LukeVassallo/tt03-xor-cipher/dual_xor_signature_arty35t_vivado/docs/dual_xor_fpga_signature.pdf

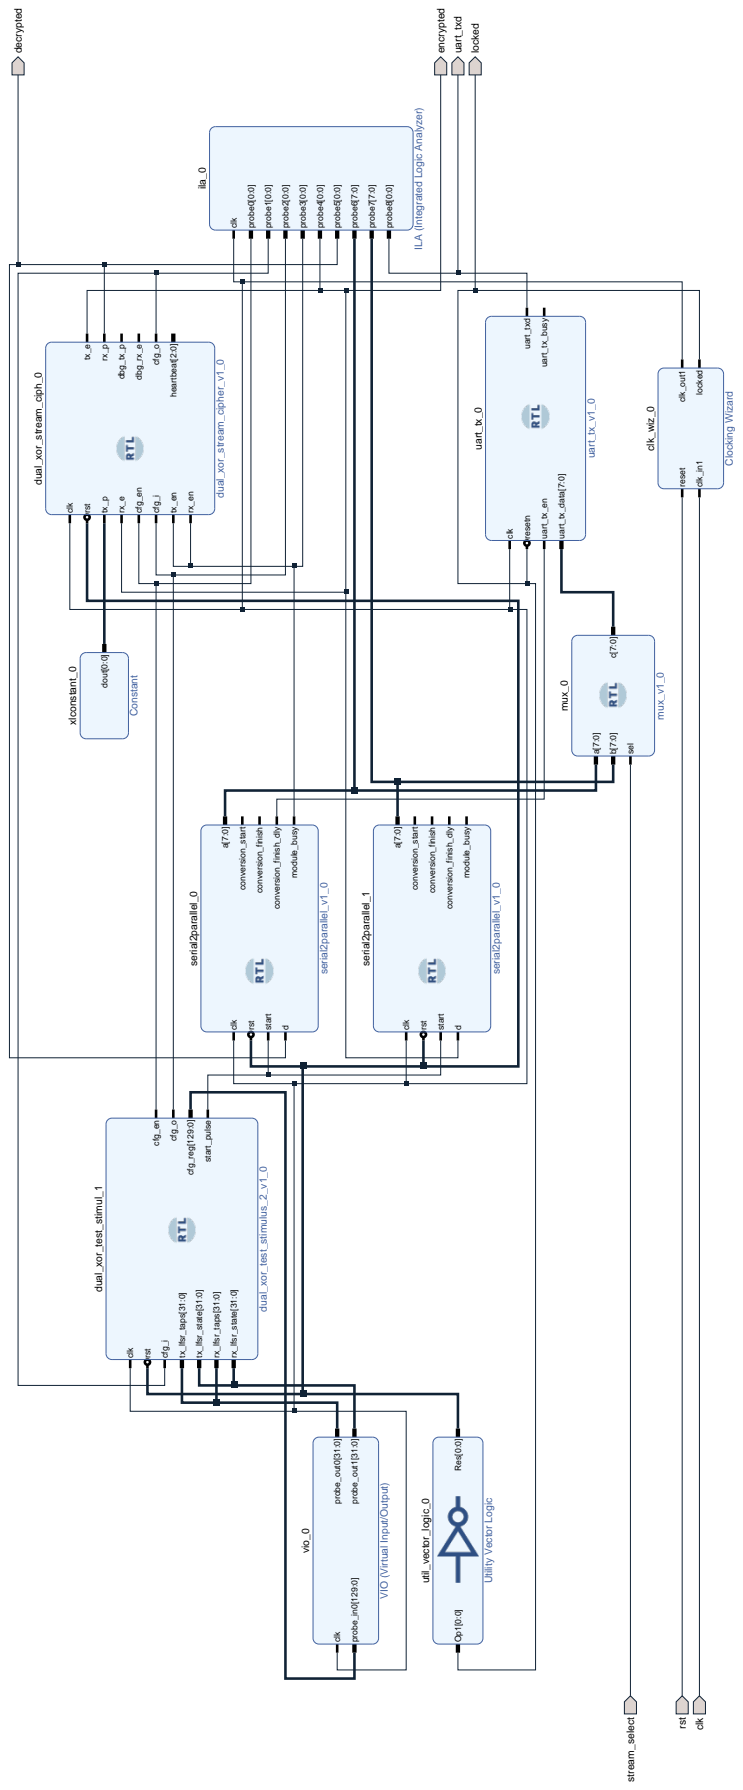
[picture p10: page 1]
stream_select; rst; clk; vio_0; probe_in0[129:0]; probe_out0[31:0]; probe_out1[31:0]; util_vector_logic_0; Op1[0:0] Res[0:0]; dual_xor_test_stimul_1; dual_xor_test_stimulus_2_v1_0; rst cfg_en; cfg_o; cfg_i; cfg_reg[129:0]; tx_lfsr_taps[31:0]; tx_lfsr_state[31:0]; rx_lfsr_taps[31:0]; rx_lfsr_state[31:0]; start_pulse; serial2parallel_0; serial2parallel_v1_0; start; conversion_start; conversion_finish; conversion_finish_dly; module_busy; serial2parallel_1; xlconstant_0; Constant; dout[0:0]; mux_0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

ILA (Integrated Logic Analyzer)

VIO (Virtual Input/Output)

Utility Vector Logic
