LukeVassallo/tt03-xor-cipher/dual_xor_basic_arty35t_vivado/docs/dual_xor_fpga_basic.pdf

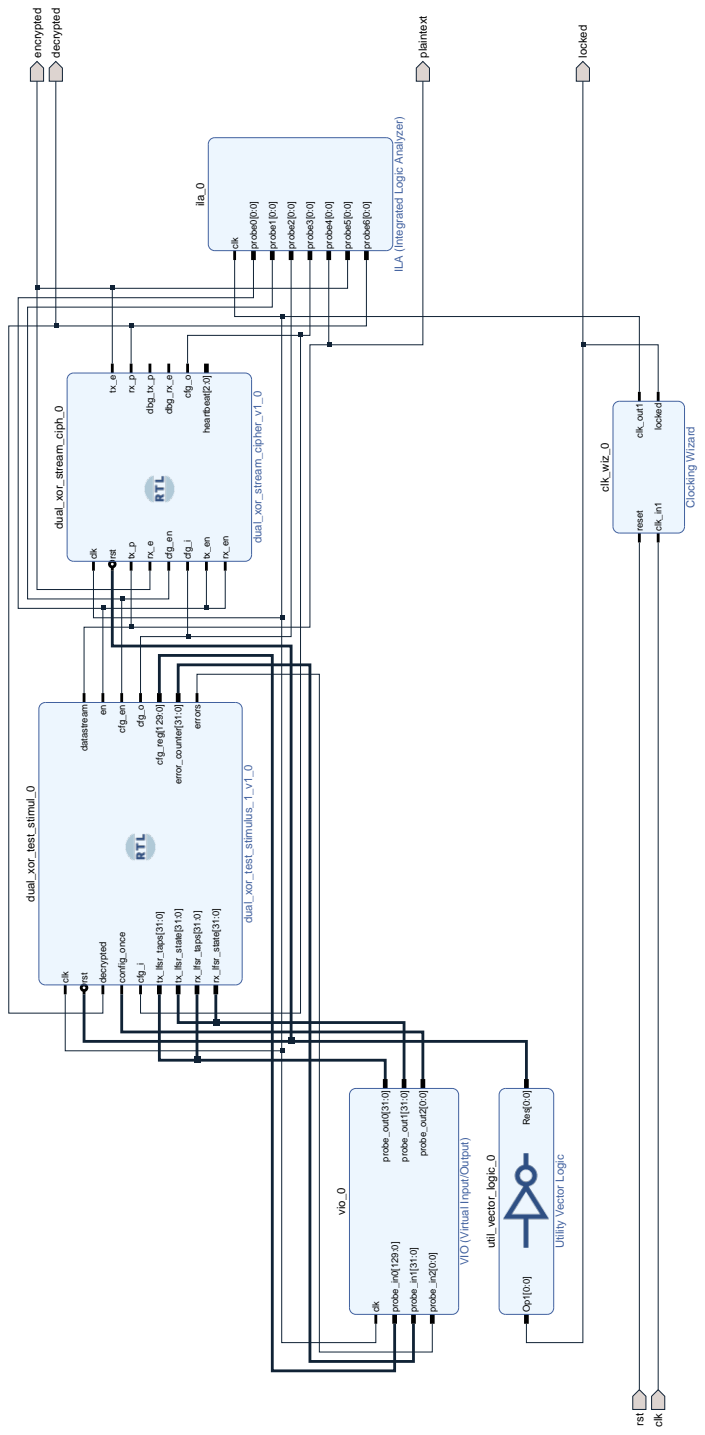
[picture p11: page 1]
rst; clk; vio_0; probe_in0[129:0]; probe_in1[31:0]; probe_in2[0:0]; probe_out0[31:0]; probe_out1[31:0]; probe_out2[0:0]; util_vector_logic_0; Op1[0:0] Res[0:0]; dual_xor_test_stimul_0; dual_xor_test_stimulus_1_v1_0; decrypted; datastream; cfg_en; cfg_o; config_once; cfg_i; cfg_reg[129:0] tx_lfsr_taps[31:0]; tx_lfsr_state[31:0]; rx_lfsr_taps[31:0]; rx_lfsr_state[31:0]; error_counter[31:0]; errors; dual_xor_stream_ciph_0; dual_xor_stream_cipher_v1_0; dbg_tx_p; dbg_rx_e cfg_en; heartbeat[2:0]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

ILA (Integrated Logic Analyzer)

VIO (Virtual Input/Output)

Utility Vector Logic
