LukeVassallo/tt03-xor-cipher/src/tb.v

`default_nettype none
`timescale 1ns/1ps

/*
this testbench just instantiates the module and makes some convenient wires
that can be driven / tested by the cocotb test.py
*/

module tb (
    // testbench is controlled by test.py
    input clk,
    input rst,
    output e,
    output d,
    output cfg_o,
    output heartbeat
   );

    // this part dumps the trace to a vcd file that can be viewed with GTKWave
    initial begin
        $dumpfile ("tb.vcd");
        $dumpvars (0, tb);
        #1;
    end

    // wire up the inputs and outputs
    wire [7:0] inputs = {6'b0, rst, clk};
    wire [7:0] outputs;
    assign e = outputs[0];
    assign d = outputs[1];
    assign cfg_o = outputs[2];
    assign heartbeat = outputs[3];
    
    // instantiate the DUT
    lukevassallo_xor_cipher dut(
        `ifdef GL_TEST
            .vccd1( 1'b1),
            .vssd1( 1'b0),
        `endif
        .io_in  (inputs),
        .io_out (outputs)
        );

endmodule
