LukeVassallo/tt03-xor-cipher/src/test.py

import cocotb
from cocotb.clock import Clock
from cocotb.triggers import RisingEdge, FallingEdge, Timer, ClockCycles


segments = [ 63, 6, 91, 79, 102, 109, 124, 7, 127, 103 ]

@cocotb.test()
async def test_xor_cipher(dut):
    dut._log.info("start")
    clock = Clock(dut.clk, 10, units="us")
    cocotb.start_soon(clock.start())

    dut._log.info("reset")
    dut.rst.value = 1
    await ClockCycles(dut.clk, 100)
    dut.rst.value = 0

    dut._log.info("e")
    dut._log.info("d")
    await ClockCycles(dut.clk, 1000)
