LukeVassallo/tt03-xor-cipher/(commit log)

2023-03-18 Added xor cipher circuit
2023-03-18 Corrected typo in module name
    [xor_cipher.v]
2023-03-18 Ran simulation and removed errors
    [test.py, xor_cipher.v]
2023-03-19 Removed asynchronous reset since I'm resetting with non-constatnt values
    [counter.v, lfsr.v, xor_cipher.v]
2023-03-24 Added missing src file
    [dual_xor_stream_cipher.v]
2023-03-24 Changed 64-bit to 48-bit registers beacuse design did not fit.
    [dual_xor_stream_cipher.v, lfsr.v]
2023-03-26 Added basic and signature examples with foss flow on ice40up5
